srepmub/tacovr/images/elec2.png

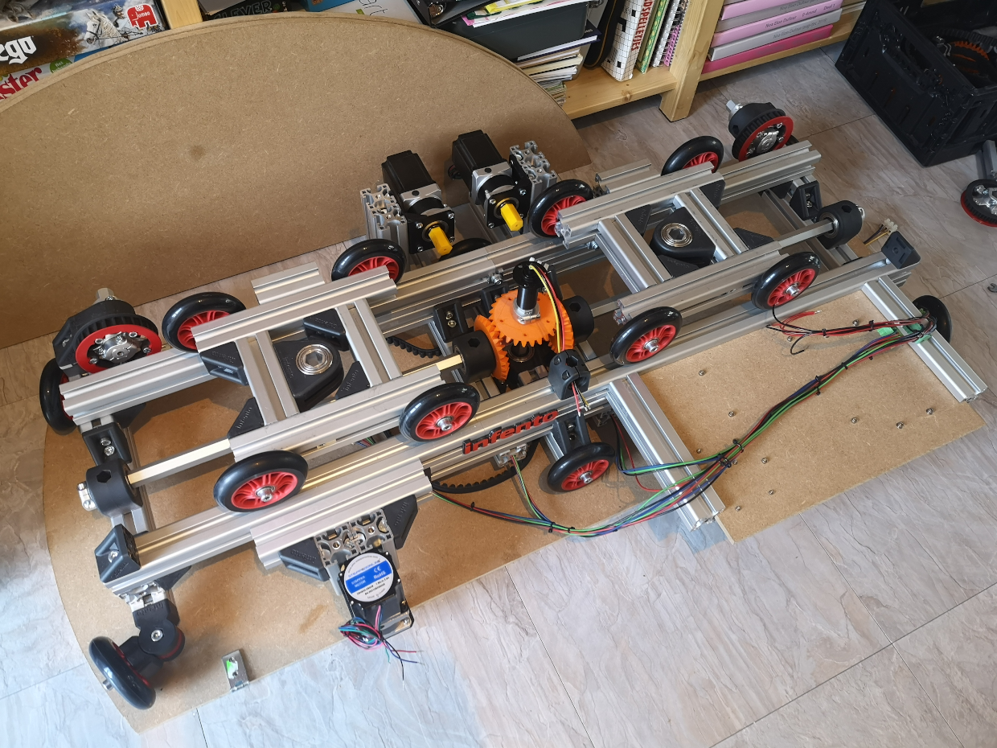
images/elec2.png
