srepmub/tacovr/images/elec.png

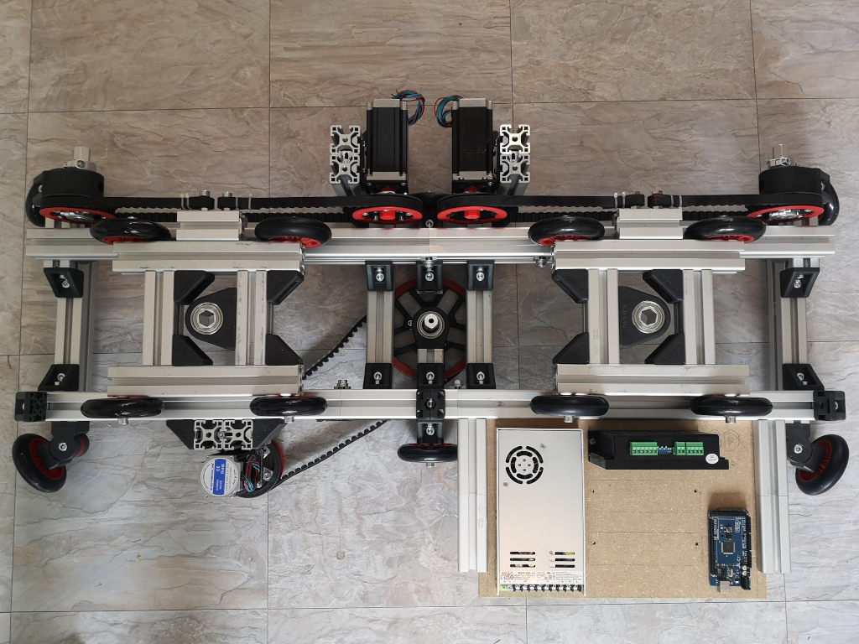
images/elec.png
