srepmub/tacovr/(commit log)

2022-05-20 Update README.md
    driver much cheaper at the source (stepperonline)
2022-06-23 basic sketich using accelstepper and ni2c
    ni2c means nonblocking-i2c, and seems more performant than the blocking wire lib, which the pixy2 library uses.
2022-07-23 add STEP/WAIT L/R states, fix Z dir for L platform
    [tacovr.ino]
